bi4242/Linjefoelger/README.md

# Linjefølger
Første store projekt i robotteknik.

To do:
- vi skal overveje, om det giver mening at agerer på ALLE målinger, vi får. Måske vi skal tage 20 målinger, og så gennemsnittet, af dem, og agerer efterfølgende, så vi ikke forsøger at korigerer kursen 1000 gange/s
