bi4242/Linjefoelger/(list of files, drawings)

Other design files:
Elektrisk kredsløb linjefølger.fzz
