bi4242/Linjefoelger/(commit log)

2026-09-29 VERSION 3!!
    Seneste sorte er fikset så det bliver reset
    Retning er nu et enum
    Stavefejl i variabler er fikset
    [linjefoelgerV3.ino]
2026-09-30 Update README with considerations for sensor data
    Discuss the approach to handling sensor measurements.
2026-10-06 Elektrisk kredsløb for hele robotten tilføjes
    [Elektrisk kredsløb linjefølger.fzz]
2026-10-06 Nye fulde elektriske diagram med billedeø
    [Elektrisk kredsløb linjefølger.fzz]
